GeunheePARKKK/MCU_Competition/handoff_images/psd_original.png

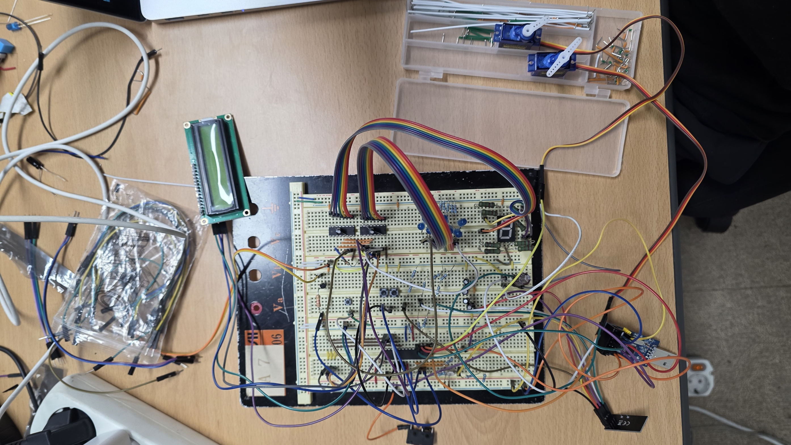
handoff_images/psd_original.png
