GeunheePARKKK/MCU_Competition/handoff_images/train_original.png

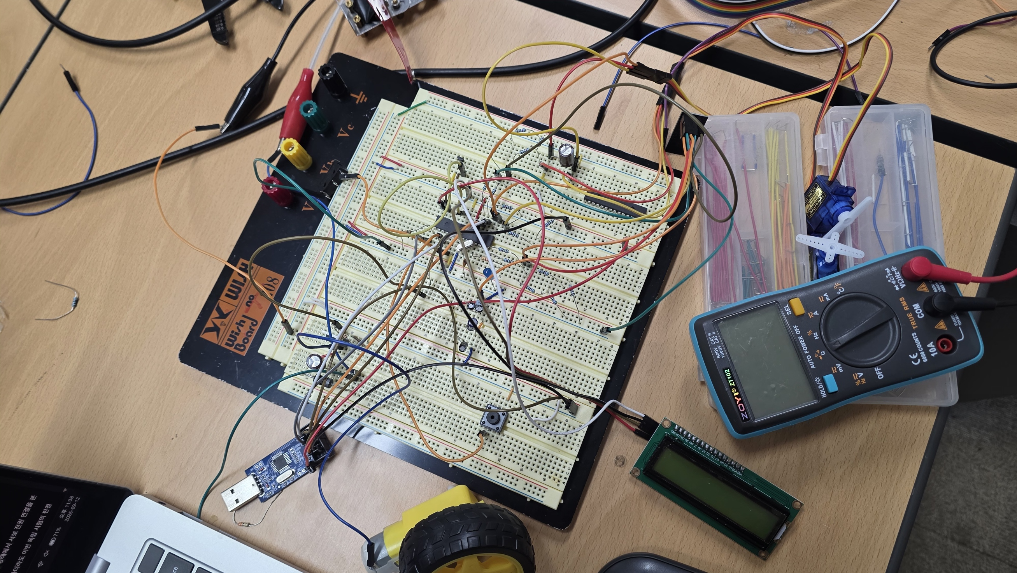
handoff_images/train_original.png
